technologiestiftung/kiezbox2-PCB/kiezbox2-PCB-1/Schaltschrank Skizze/Hardwareanordnung im Schaltschrank.pdf

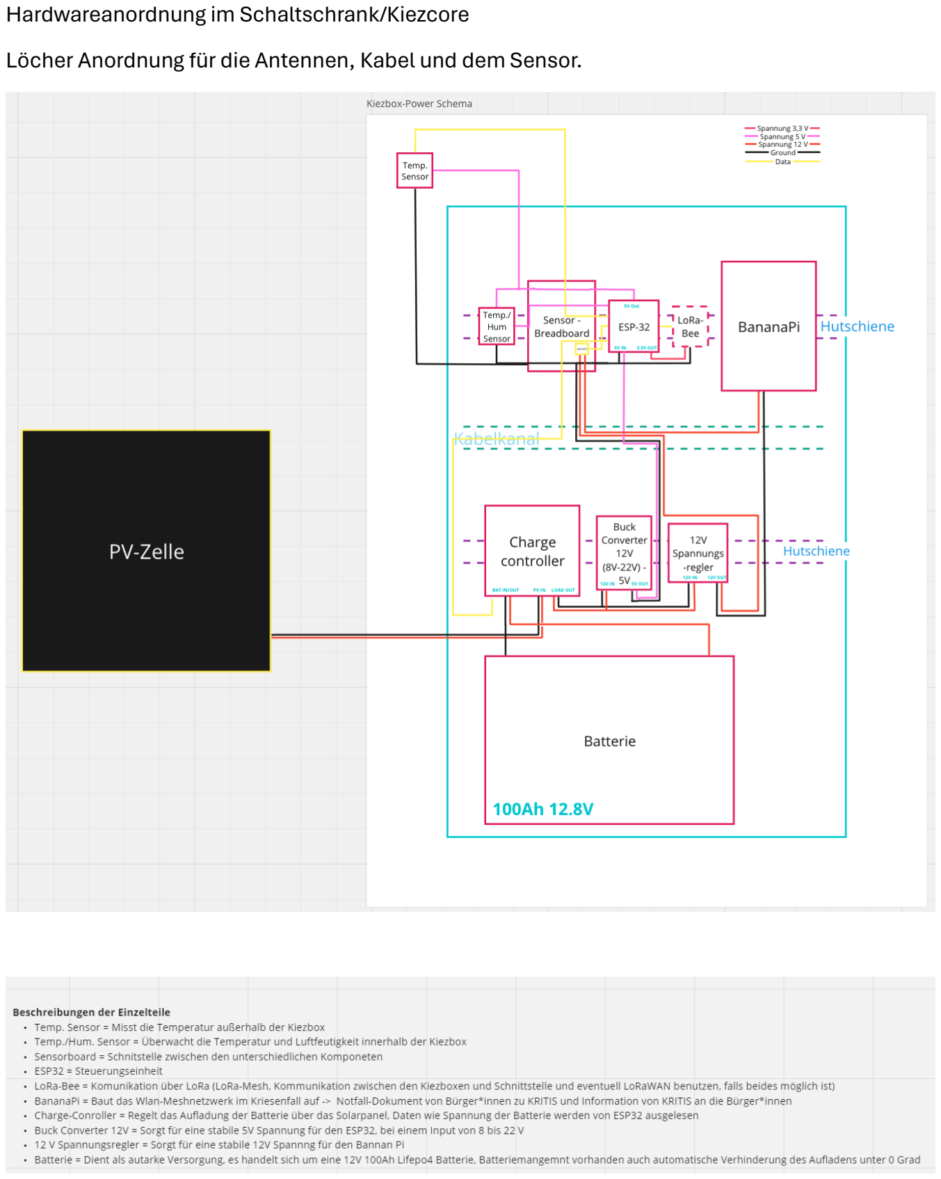
[picture p1: page 1]

Hardwareanordnung im Schaltschrank/Kiezcore
Löcher Anordnung für die Antennen, Kabel und dem Sensor.

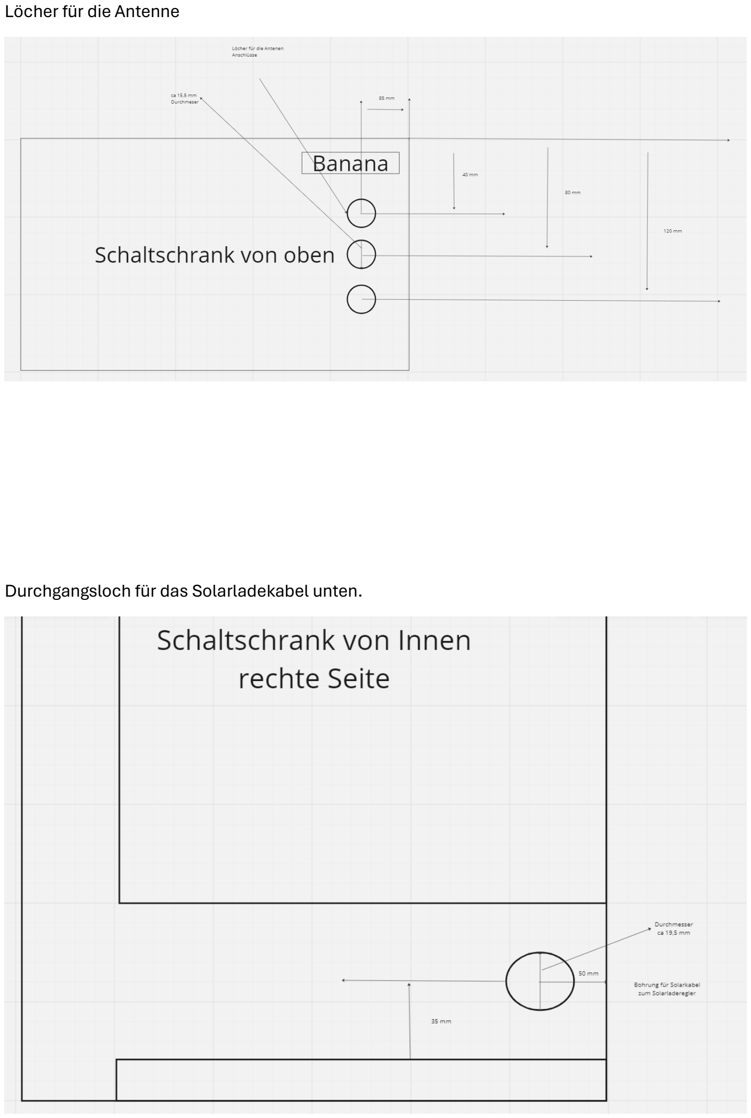
[picture p2: page 2]

Löcher für die Antenne

Durchgangsloch für das Solarladekabel unten.

Loch für den Außentemperatursensor oben (Der Sensor befindet sich im zwischen Bereich)

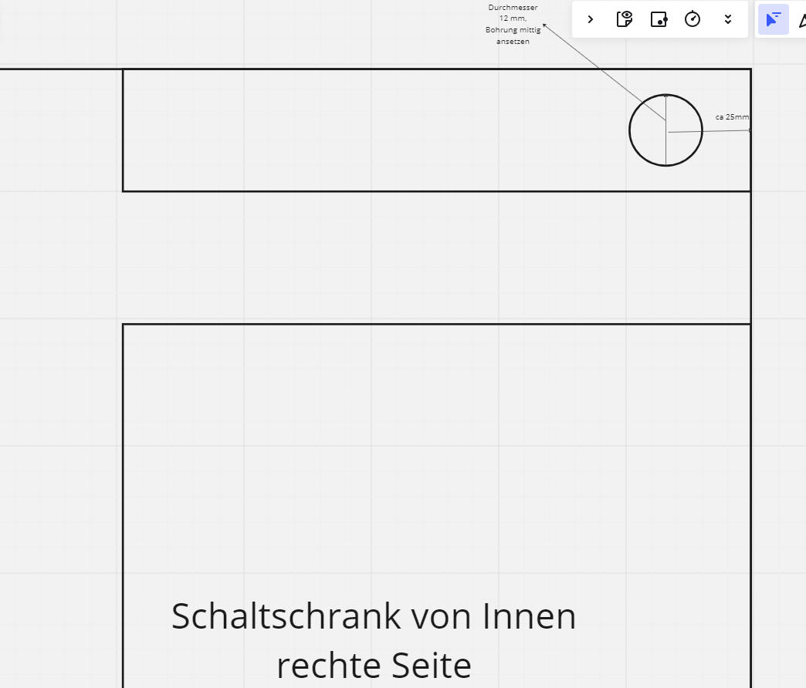
[picture p3: figure]
