technologiestiftung/kiezbox2-PCB/(commit log)

2024-03-28 feat: Add GND symbols and current labels
2024-03-28 feat: add gitignore
    [KiezBox_SensorBoard.kicad_sch]
2024-04-10 feat: add P-Chanel Mosfet for High-Side-Switching
    [KiezBox_SensorBoard.kicad_sch]
2024-04-15 fix: fix shifted connection
    [KiezBox_SensorBoard.kicad_sch]
2024-04-16 fix: remove unused power terminals
    [KiezBox_SensorBoard.kicad_sch]
2024-04-23 add ESP32 and LoRaBee
    [KiezBox_SensorBoard.kicad_sch]
2024-04-25 update PCB
    [KiezBox_SensorBoard.kicad_sch]
2024-04-25 fix: wire, ground in PCB, and picture in PDF
    [KiezBox_SensorBoard.kicad_sch]
